mymakercorner/Leyden_Jar/pcb/ps2_at_daughterboard/ps2_pcb.kicad_pcb

## KiCad design pcb/ps2_at_daughterboard/ps2_pcb.kicad_pcb (2023-05-26)

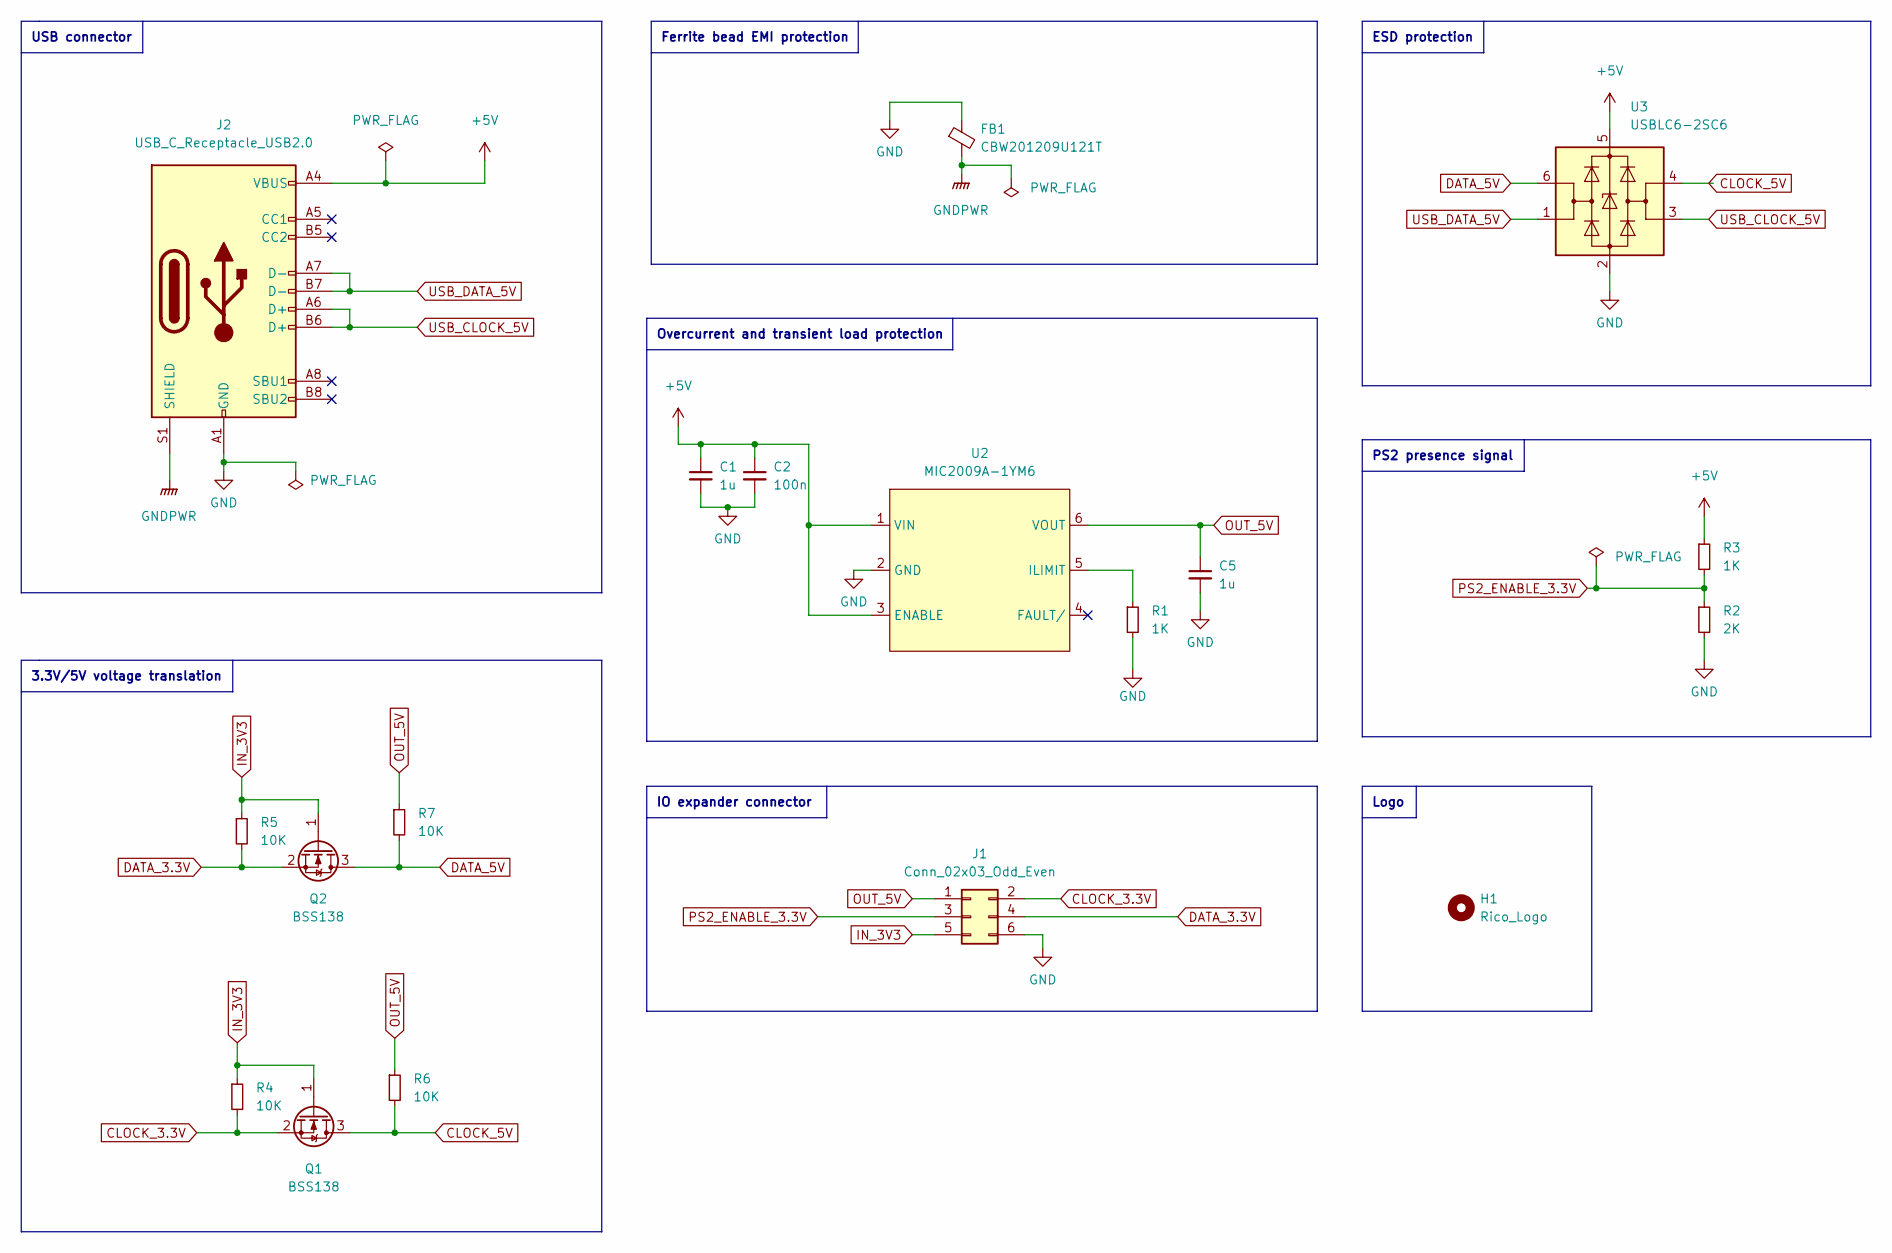
[picture p1: schematic ps2_pcb.kicad_sch, PS2 AT to USB Daughterboard for Leyden Jar controller]

Parts:
C1, C5: 1u; Capacitor_603; LCSC C52923
C2: 100n; Capacitor_603; LCSC C1525
FB1: CBW201209U121T; R_805; LCSC C139186
H1: Rico_Logo
J1: Conn_02x03_Odd_Even; PinSocket_2x03_P2.54mm_Horizontal
J2: USB_C_Receptacle_USB2.0; USB_C_Receptacle_HRO_TYPE-C-31-M-12; LCSC C165948
Q1, Q2: BSS138; SOT-23; LCSC C2874697
R1, R3: 1K; Resistor_603; LCSC C11702
R2: 2K; Resistor_603; LCSC C100291
R4, R5, R6, R7: 10K; Resistor_603; LCSC C25744
U2: MIC2009A-1YM6; SOT-23-6; LCSC C625657
U3: USBLC6-2SC6; SOT-23-6; LCSC C7519

Connections:
+5V: C1.1, C2.1, J2.A4 (VBUS), J2.A9 (VBUS), J2.B4 (VBUS), J2.B9 (VBUS), R3.1, U2.1 (VIN), U2.3 (ENABLE), U3.5 (VBUS)
CLOCK_3.3V: J1.2, Q1.2 (S), R4.2
CLOCK_5V: Q1.3 (D), R6.2, U3.4 (I/O2)
DATA_3.3V: J1.4, Q2.2 (S), R5.2
DATA_5V: Q2.3 (D), R7.2, U3.6 (I/O1)
GND: C1.2, C2.2, C5.2, FB1.1, J1.6, J2.A1 (GND), J2.A12 (GND), J2.B1 (GND), J2.B12 (GND), R1.2, R2.2, U2.2 (GND), U3.2 (GND)
GNDPWR: FB1.2, J2.S1 (SHIELD)
IN_3V3: J1.5, Q1.1 (G), Q2.1 (G), R4.1, R5.1
unnamed: R1.1, U2.5 (ILIMIT)
OUT_5V: C5.1, J1.1, R6.1, R7.1, U2.6 (VOUT)
PS2_ENABLE_3.3V: J1.3, R2.1, R3.2
USB_CLOCK_5V: J2.A6 (D+), J2.B6 (D+), U3.3 (I/O2)
USB_DATA_5V: J2.A7 (D-), J2.B7 (D-), U3.1 (I/O1)

Notes on the sheet:
ESD protection
Overcurrent and transient load protection
Logo
3.3V/5V voltage translation
PS2 presence signal
IO expander connector
Ferrite bead EMI protection
USB connector

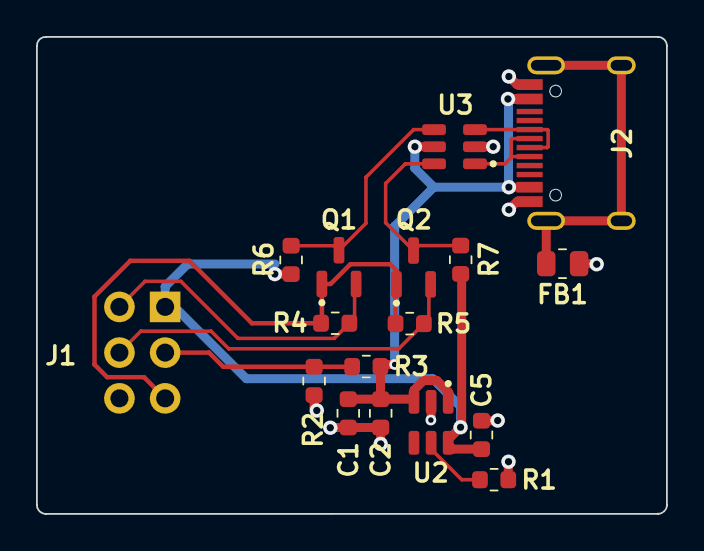
[picture p2: board ps2_pcb.kicad_pcb from above]

Board: 2 copper layers, 35.0 x 26.5 mm, 18 parts (1 on the bottom side), 13 nets.
